yash-izate/ai-enabled-maternal-monitoring-assistance/Documentation/Hardware_PCB_Sitting_Demo_Classification.jpeg

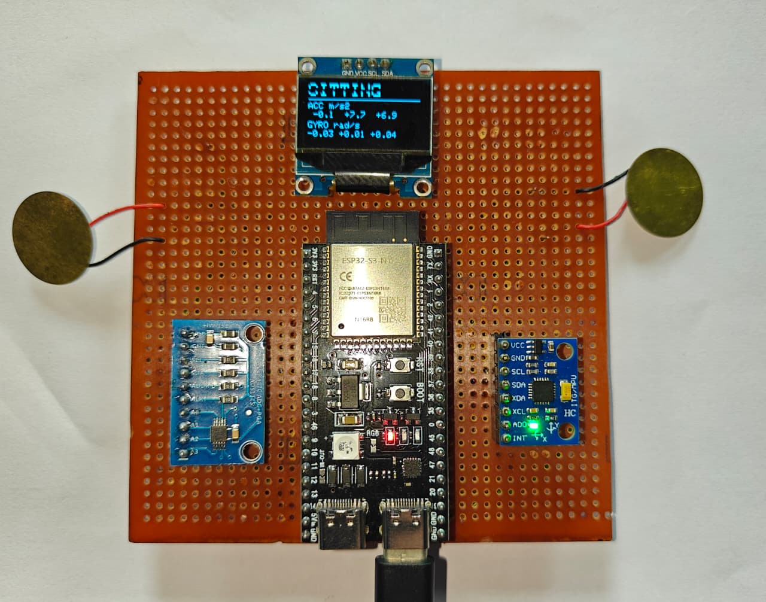
Documentation/Hardware_PCB_Sitting_Demo_Classification.jpeg
