yash-izate/ai-enabled-maternal-monitoring-assistance/Documentation/Hardware_Live_Reading_Oled.jpeg

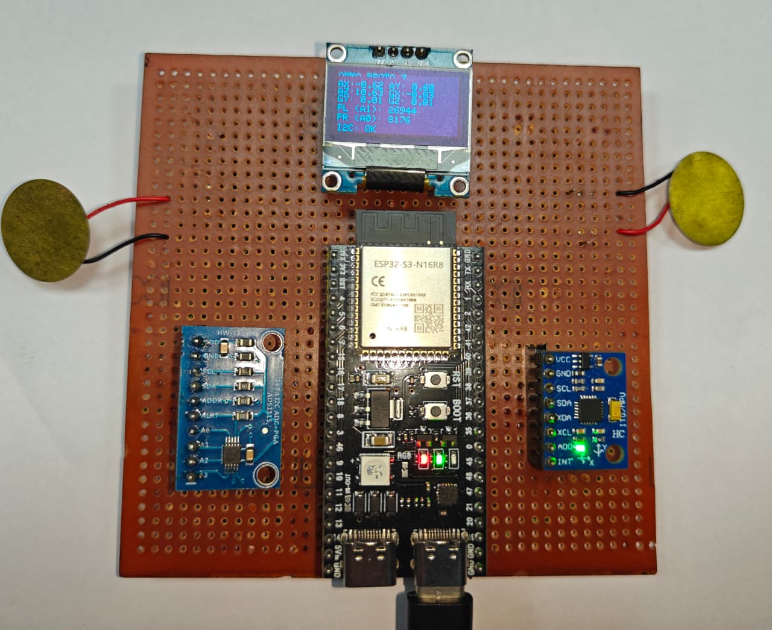
Documentation/Hardware_Live_Reading_Oled.jpeg
