yash-izate/ai-enabled-maternal-monitoring-assistance/Documentation/AMMA_Application_UI.jpeg

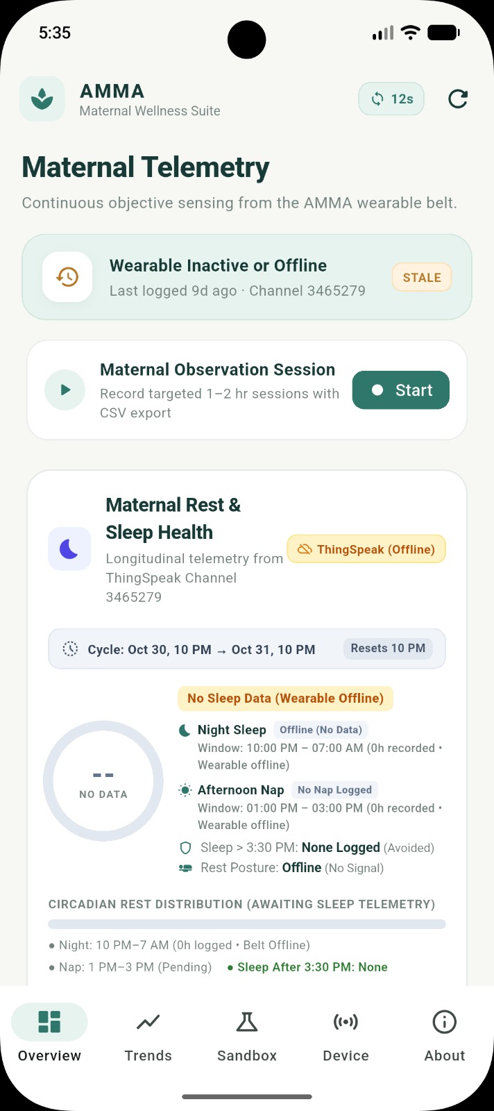
Documentation/AMMA_Application_UI.jpeg
