yash-izate/ai-enabled-maternal-monitoring-assistance/Documentation/Application_Bluetooth_Connection.jpeg

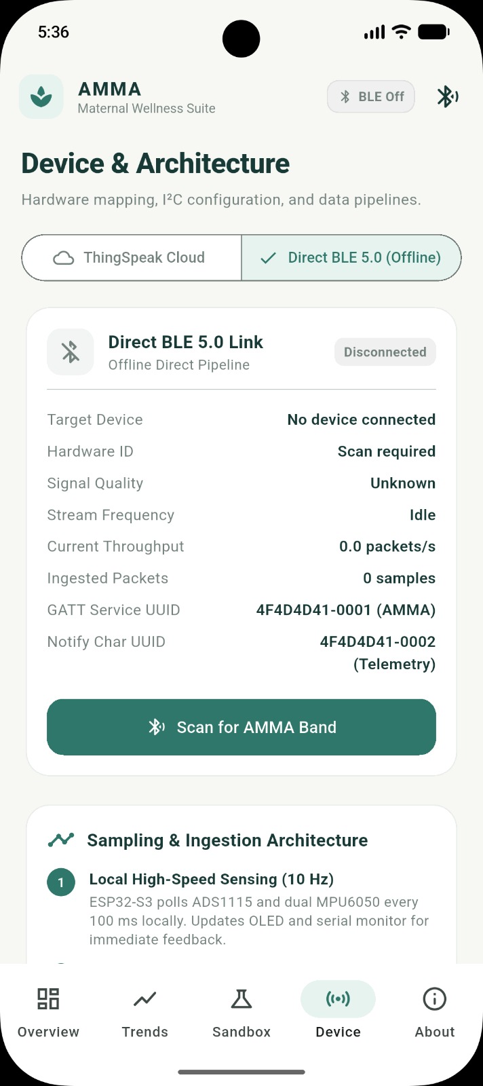
Documentation/Application_Bluetooth_Connection.jpeg
