yash-izate/ai-enabled-maternal-monitoring-assistance/Documentation/Application_Bluetooth_Scan_Mode.jpeg

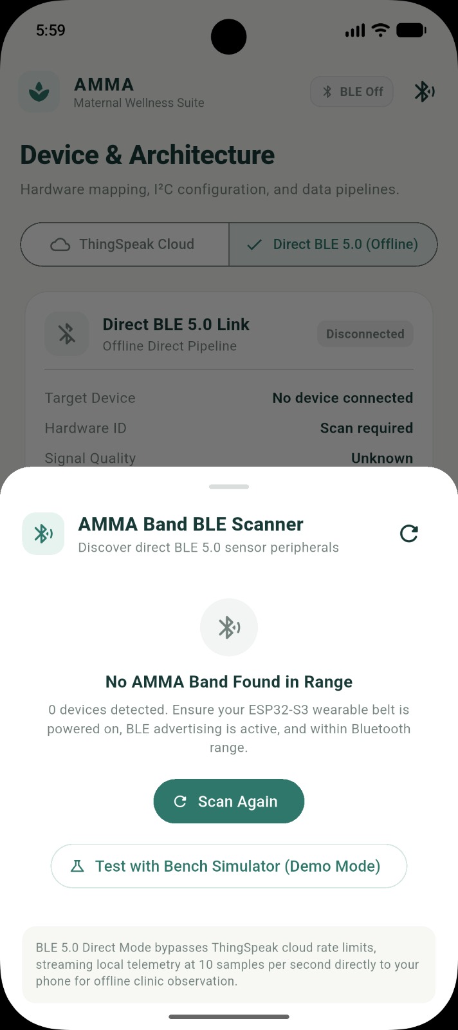
Documentation/Application_Bluetooth_Scan_Mode.jpeg
