yash-izate/ai-enabled-maternal-monitoring-assistance/Documentation/Application_Kick_Data.jpeg

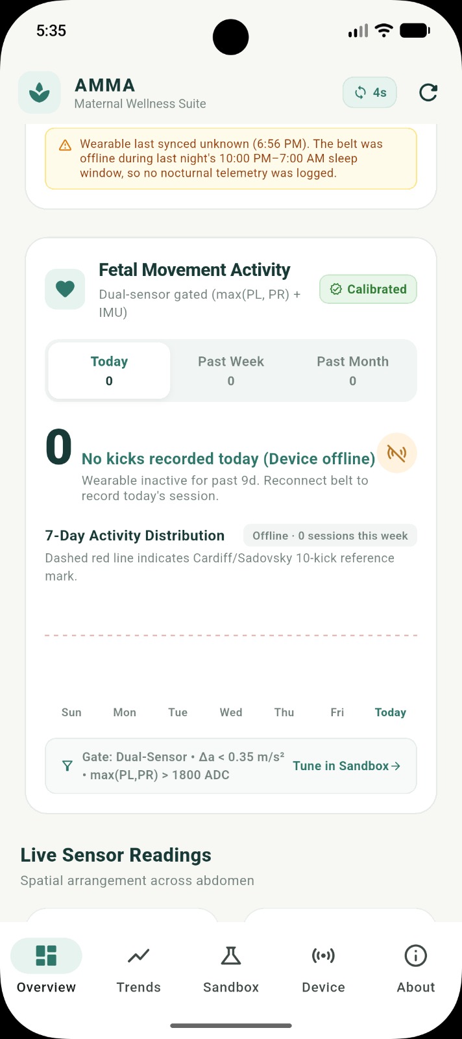
Documentation/Application_Kick_Data.jpeg
