yash-izate/ai-enabled-maternal-monitoring-assistance/Documentation/Application_Live_Sensor_Readings.jpeg

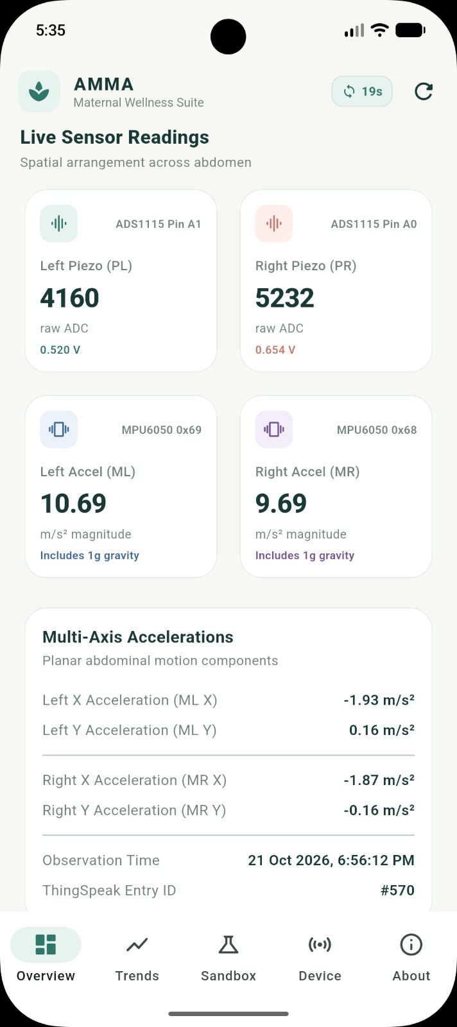
Documentation/Application_Live_Sensor_Readings.jpeg
