yash-izate/ai-enabled-maternal-monitoring-assistance/Documentation/Application_Project_Contributor.jpeg

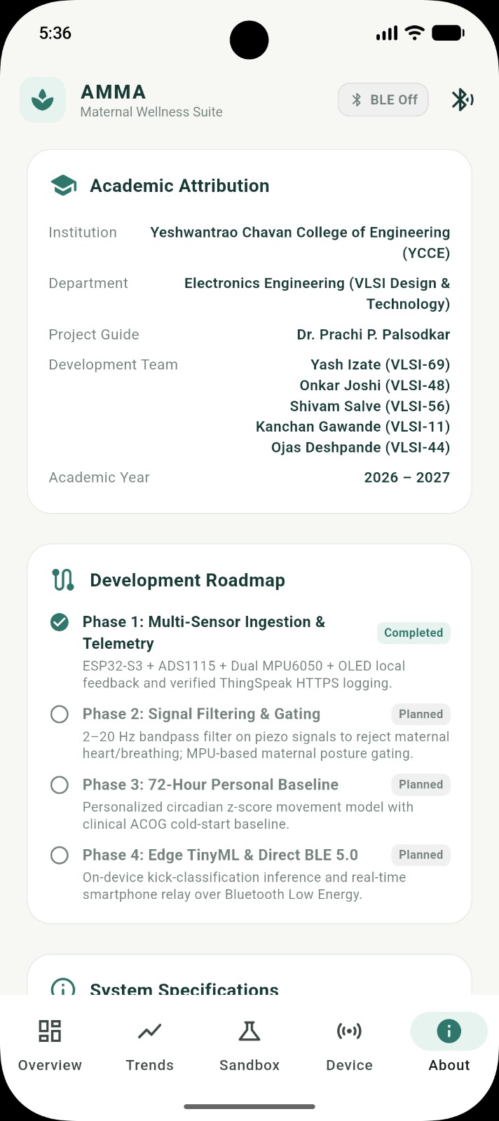
Documentation/Application_Project_Contributor.jpeg
