yash-izate/ai-enabled-maternal-monitoring-assistance/Documentation/Application_Thingspeak_Cloud_connect.jpeg

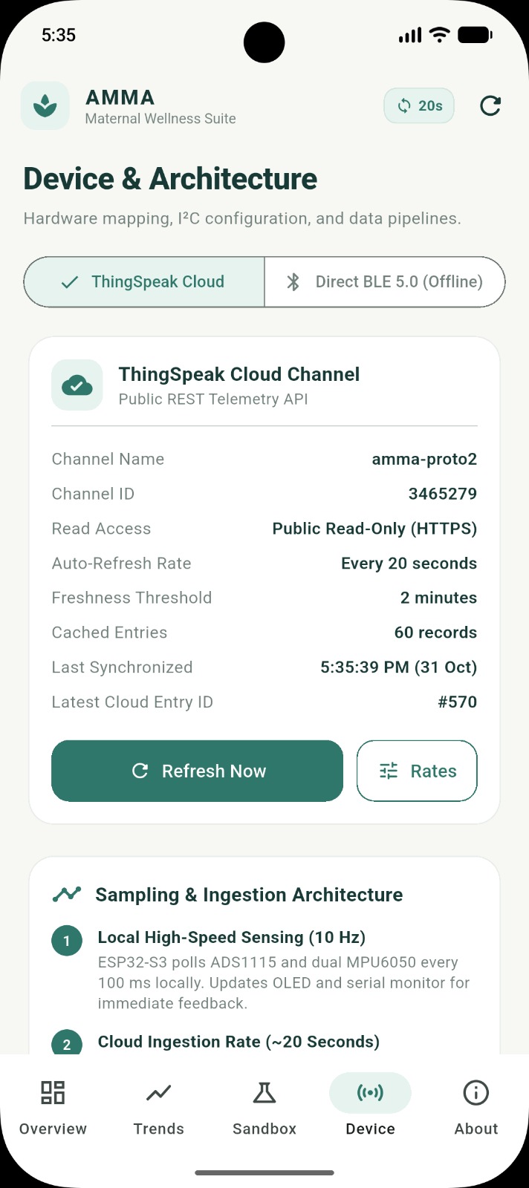
Documentation/Application_Thingspeak_Cloud_connect.jpeg
