yash-izate/ai-enabled-maternal-monitoring-assistance/Documentation/Application_Thingspeak_Setting.jpeg

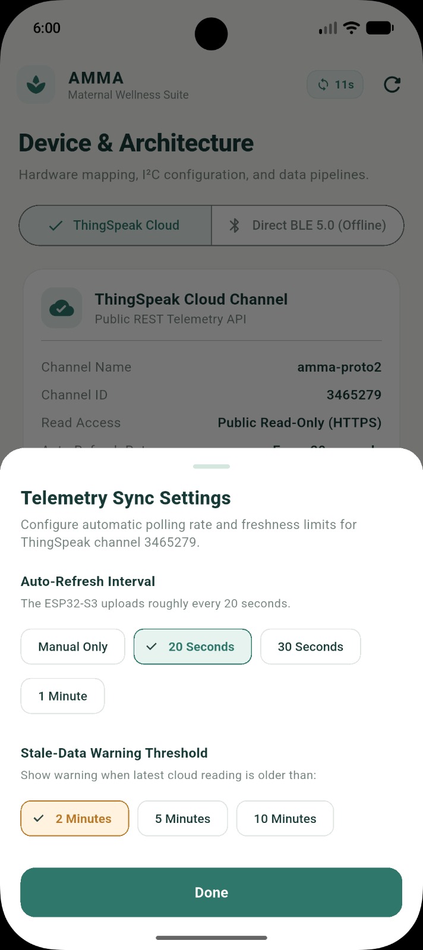
Documentation/Application_Thingspeak_Setting.jpeg
