yash-izate/ai-enabled-maternal-monitoring-assistance/(commit log)

2026-10-21 Add README for AMMA Prototype 2 documentation
    Added comprehensive project documentation for AMMA Prototype 2, detailing system architecture, objectives, hardware components, data acquisition, cloud integration, and future improvements.
2026-10-21 ok report for data logging
    [AMMA_5MIN_20261021_190231.csv]
2026-10-21 add data
    [AMMA_5MIN_20261021_190231.csv]
